mingkikiki/2025ESWContest_free_AIM/src/STM32/Circuit Diagram/circuit_6.0.png

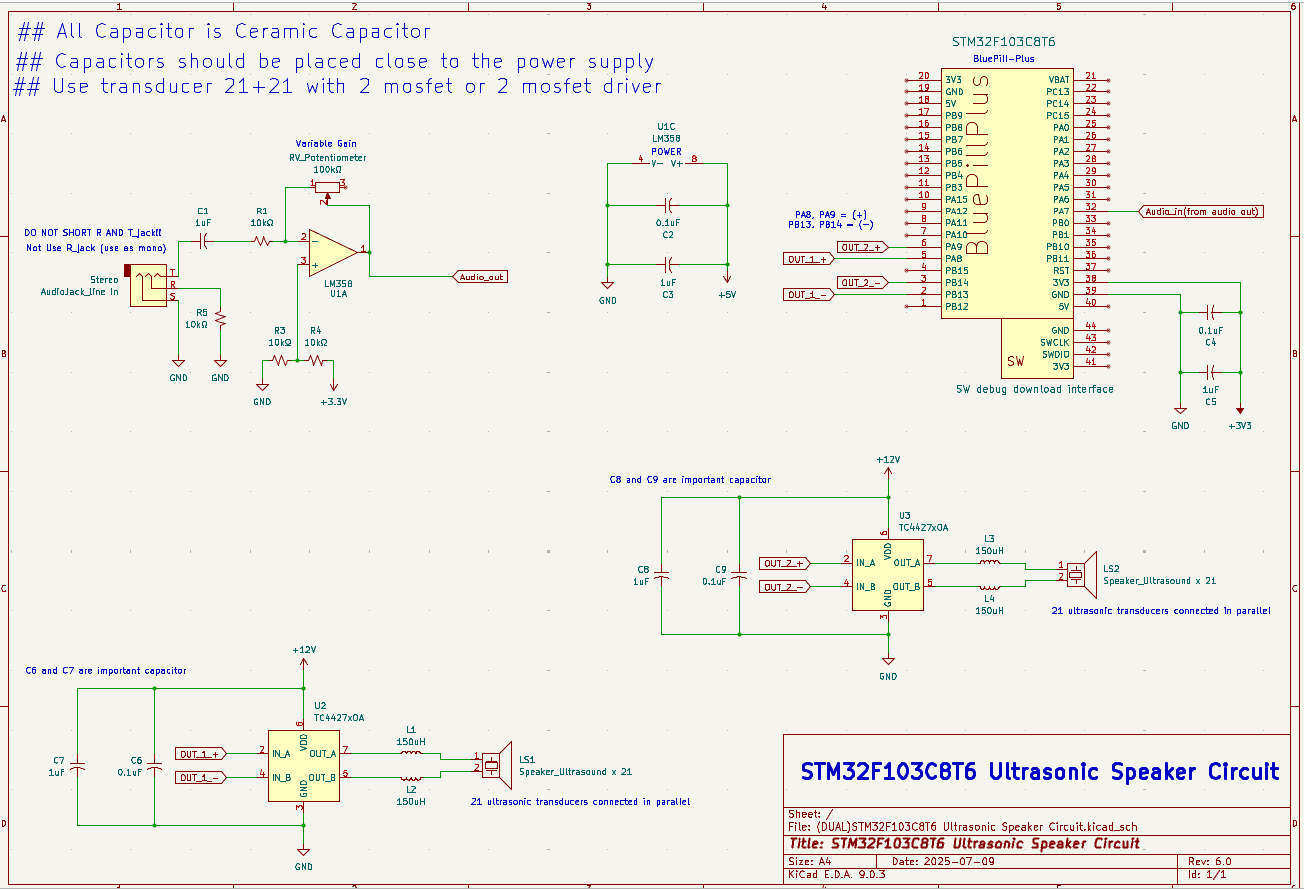
src/STM32/Circuit Diagram/circuit_6.0.png
