mingkikiki/2025ESWContest_free_AIM/src/STM32/Circuit Diagram/transducer_array.png

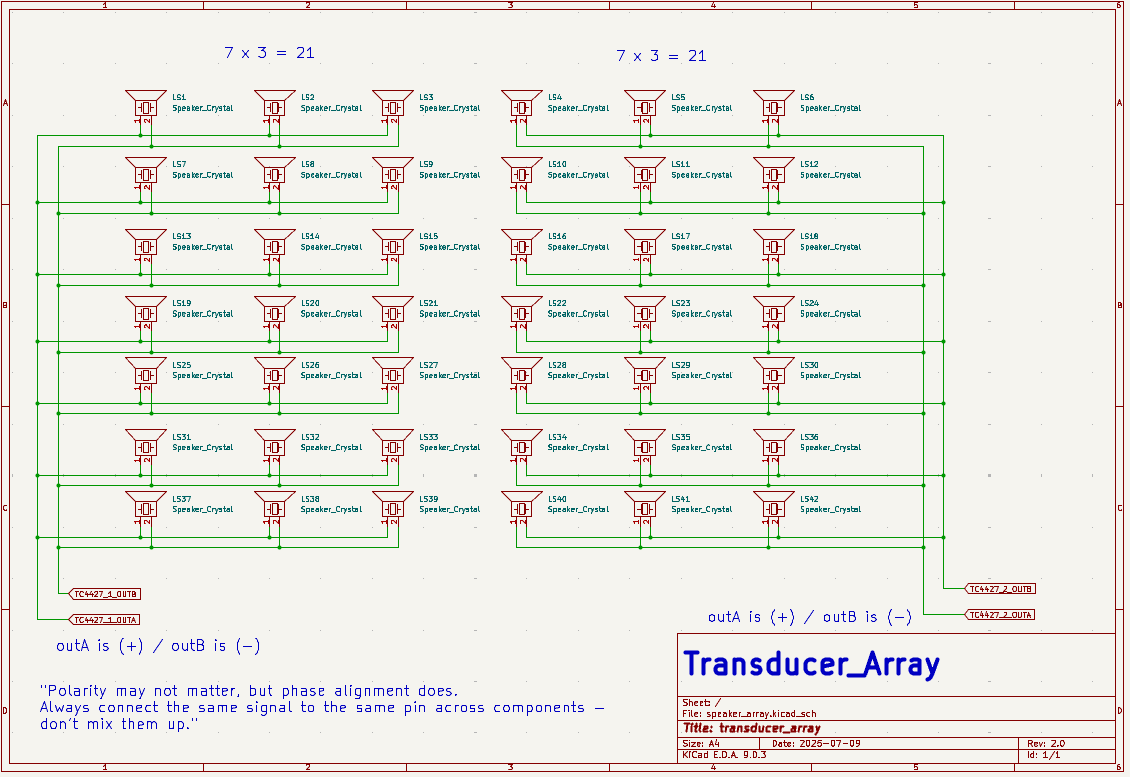
src/STM32/Circuit Diagram/transducer_array.png
