mingkikiki/2025ESWContest_free_AIM/src/STM32/main_PB2.c

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
/* Includes ------------------------------------------------------------------*/
#include "main.h"

/* USER CODE BEGIN PD */
#define PWM_OVERFLOW 1800 //40KHz ARR
#define PWM_OVERFLOW_HALF (PWM_OVERFLOW/2) // (PWM_OVERFLOW / 2)
#define ADC_MID_VALUE 2048 //ADC input range / 2 = 2048

/* USER CODE END PD */

ADC_HandleTypeDef hadc1;
DMA_HandleTypeDef hdma_adc1;

TIM_HandleTypeDef htim1;
TIM_HandleTypeDef htim3;

/* USER CODE BEGIN PV */
volatile uint16_t adc_buffer[1]; //DMA buffer

/* USER CODE END PV */

void SystemClock_Config(void);
static void MX_GPIO_Init(void);
static void MX_DMA_Init(void);
static void MX_ADC1_Init(void);
static void MX_TIM1_Init(void);
static void MX_TIM3_Init(void);
/* USER CODE BEGIN 0 */
void led_blink_heartbeat() //mcu life indicator
{
    static uint32_t last_tick = 0;
    static uint8_t led_on = 0;

    if (HAL_GetTick() - last_tick >= 500) {
        last_tick = HAL_GetTick();
        led_on = !led_on;
        HAL_GPIO_WritePin(GPIOB, GPIO_PIN_2, led_on ? GPIO_PIN_SET : GPIO_PIN_RESET);
    }
}

/* USER CODE END 0 */

/**
  * @brief  The application entry point.
  * @retval int
  */
int main(void)
{

  /* MCU Configuration--------------------------------------------------------*/

  /* Reset of all peripherals, Initializes the Flash interface and the Systick. */
  HAL_Init();

  /* Configure the system clock */
  SystemClock_Config();

  /* Initialize all configured peripherals */
  MX_GPIO_Init();
  MX_DMA_Init();
  MX_ADC1_Init();
  MX_TIM1_Init();
  MX_TIM3_Init();
  /* USER CODE BEGIN 2 */
  //initializing code
  //TIM1 CH1 start define
  HAL_TIM_PWM_Start(&htim1, TIM_CHANNEL_1);
  HAL_TIMEx_PWMN_Start(&htim1, TIM_CHANNEL_1);

  //TIM1 CH2 start define
  HAL_TIM_PWM_Start(&htim1, TIM_CHANNEL_2);
  HAL_TIMEx_PWMN_Start(&htim1, TIM_CHANNEL_2);

  //TIM3 start define
  HAL_TIM_Base_Start(&htim3);

  //start ADC with DMA
  HAL_ADC_Start_DMA(&hadc1, (uint32_t *)adc_buffer, 1);

  //start timer1`s update event
  HAL_TIM_Base_Start_IT(&htim1);

  /* USER CODE END 2 */

  /* Infinite loop */
  /* USER CODE BEGIN WHILE */
  while (1)
  {
    /* USER CODE END WHILE */

    /* USER CODE BEGIN 3 */
	  led_blink_heartbeat();
  }
  /* USER CODE END 3 */
}

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
/* USER CODE BEGIN 4 */

//interrupt function define
void HAL_TIM_PeriodElapsedCallback(TIM_HandleTypeDef *htim)
{
	if (htim->Instance == TIM1)
	{
	    // Swing around the center value — calculate how far the sample deviates from the center
	    int16_t deviation = (int16_t)adc_buffer[0] - ADC_MID_VALUE; // ADC is 12-bit, so at least 16-bit is needed. Also, the value can be negative.

	    /* Formula explanation:
	     * dutyShift : 900 = deviation : 2048
	     * dutyShift = (900 * deviation) / 2048
	     * This maps the ADC range of 0–4095 to a PWM duty shift range of -900 to +900.
	     * Decimal precision is meaningless in PWM (digital modulation), so it's ignored.
	     */
	    int32_t dutyShift = ((int32_t)deviation * PWM_OVERFLOW_HALF) / ADC_MID_VALUE;

	    // Calculate the final amount of modulation, based on center value 900
	    int32_t pwmDuty_32 = (PWM_OVERFLOW_HALF) + dutyShift;

	    // Clamp the modulation to stay within valid range
	    if (pwmDuty_32 < 0) {
	        pwmDuty_32 = 0;
	    } else if (pwmDuty_32 >= PWM_OVERFLOW) {
	        pwmDuty_32 = PWM_OVERFLOW - 1;
	    }

	    // Always cast to correct type before output. PWM duty cannot be negative.
	    uint16_t Final_output_PWM = (uint16_t)pwmDuty_32;

	    // Final output
	    __HAL_TIM_SET_COMPARE(&htim1, TIM_CHANNEL_1, Final_output_PWM);
	    __HAL_TIM_SET_COMPARE(&htim1, TIM_CHANNEL_2, Final_output_PWM);
	}
}
/* USER CODE END 4 */
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
