mingkikiki/2025ESWContest_free_AIM/(commit log)

2025-07-07 Update and rename Dual_PWM_Final.ioc to src/STM32/Dual_PWM_Final.ioc
2025-07-07 Update and rename Dual_PWM_Final2.ioc to src/STM32/Dual_PWM_Final2.ioc
2025-07-08 Delete src/AI/temp.txt
    임시파일 삭제
2025-07-08 Update README.md
    라이센스 수정
