mingkikiki/2025ESWContest_free_AIM/(notices)

Notices in the files:
src/STM32/main_PB2.c:
Copyright (C) 2019,2020 Gene Ruebsamen
This program is free software: you can redistribute it and/or modify
it under the terms of the GNU General Public License as published by
the Free Software Foundation, either version 2 of the License, or
(at your option) any later version.
